TBach17112003/Design-And-Evaluate-Indoor-Light-Harvesting-Module/(list of files, drawings)

Other design files:
NBM.PcbDoc
NBM.SchDoc
NEH.PcbDoc
NEH.SchDoc
